zbylon80/esp32-atari-console/(commit log)

2026-11-01 Initial public release: ESP32 Atari console and step-by-step setup
    [partitions-ota.csv]
2026-11-01 Keep pad buttons responsive while waiting for neutral axes
2026-11-13 Complete bilingual DIY guides and wiring references
2026-11-13 Add storage diagnostics and configurable Atari system buttons
